hessu/arduino-powermunin/img/photo-sensor-installed1-800.jpg

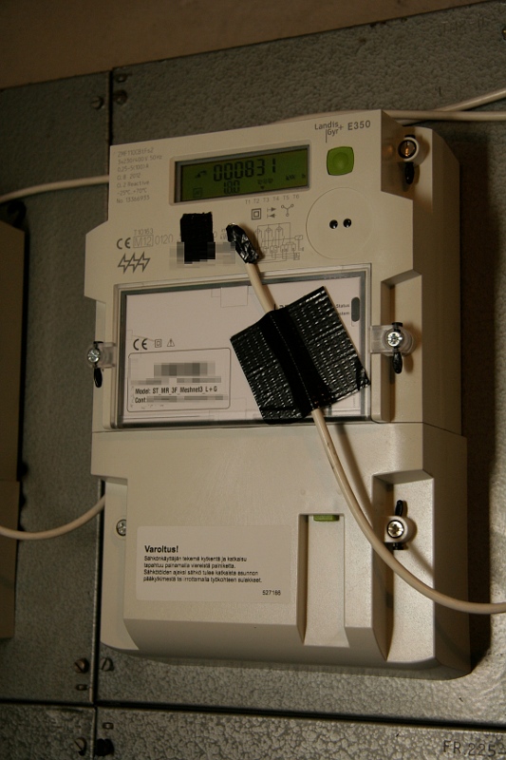
img/photo-sensor-installed1-800.jpg
