hessu/arduino-powermunin/README.md

arduino-powermunin
==================

This is a very simple but working project to monitor the blinking led on
common electricity meters (power meters) installed by utility companies.

Minimum amount of components and code, but it works. Takes one evening to
set up.

Example munin graph

License (same as Perl)
----------------------

This is free software; you can redistribute it and/or modify it under the
terms of either:

a) the GNU General Public License as published by the Free Software
Foundation; either version 1, or (at your option) any later version, or

b) the "Artistic License".

Required hardware
-----------------

1. An Arduino (I used a Duemilanove, but Uno, or anything else goes).
2. At least one phototransistor sensitive to visible light (many are only
   sensitive to infrared, and I don't know how much infrared a normal
   red LED produces). Osram SFH 300 seems to work fine. I used 5
   phototransistors since I'm monitoring 5 power meters!
3. 2 wires to connect the phototransistor to the Arduino (I used 5-wire
   phone cable, 3-wire telephone cable would work too, or just about
   anything else).
4. Header pins to stick in the Arduino's header for soldering the wires.
5. USB cable to connect the Arduino to a computer.

Theory of operation
-------------------

The Atmel microcontroller has an internal pull-up resistor which appears to
be adequate for driving the SFH 300.  The arduino code sets the digital I/O
pin to be an input, then writes HIGH to it, which enables internal pull-up. 
The I/O pin goes to HIGH state (+5V through the built-in pull-up resistor).

When the red led of the power meter blinks, the phototransistor starts to
conduct, short-circuiting the I/O pin to ground (through the pull-up
resistor which kindly limits the current to some nice value which don't care
much about).  The input pin's value is read by the arduino code, and it now
shows a LOW value.  When the light goes out, the phototransistor stops
conducting and the voltage on the I/O pin goes back up to 5V, and a
digitalRead() in the arduino code reports HIGH again.

The arduino code runs in a loop, reads I/O pin states, counts the amount of
blinks (how many times has a pin gone from HIGH to LOW), and prints the
counts on the (USB) serial port every 5 seconds.

A daemon written in Perl (powermunind) reads the reports on the serial port,
prints them to a state file on disk (or tmpfs to reduce disk I/O or flash
wearout).

A munin plugin written as a very simple shell script (power_munin) dumps the
contents of that state file when run by the munin agent.

Building and Installation instructions (short version)
------------------------------------------------------

1. Install a single phototransistor (i used Osram SFH 300) to an IO pin
   of the Arduino.  Used pins are defined in the arduino source code. 
   Connect the short lead (collector) to the IO pin and the long lead
   (emitter) to a ground pin of the Arduino.  When using multiple sensors,
   tie all emitters to the same ground pin.
2. Install the blinkcount Arduino code (found in the blinkcount
   subdirectory) on the Arduino.
3. Test the setup by pointing the phototransistor at a bright light source,
   or bringing it very close to a burning led light.  Observe accumulated
   counters printed on the USB serial port using the Arduino IDE's serial
   monitor.
4. Tape the phototransistor tightly in front of the red blinking led
   of the electricity meter.  It's a bit unsensitive, so make sure the led
   and the phototransistor are aligned to point directly at each other.  If
   the meter is in a well-luminated place instead of a dark closet like
   mine, put black tape on the back of the transistor so that the light from
   the outside does not interfere.
5. Run src/powermunind which collects counter increments and dumps them
   to a state file. Put it in a startup script such as /etc/rc.local
   so that it starts up after a reboot.
6. Install src/power_munin munin plugin which gives out the state file
   to munin. Optionally, set some configuration within the script.

Adjustments for different power meters
--------------------------------------

On my power meter the led blinks 1000 times per kWh, meaning 1 blink is 1 Wh
(1 watt consumed in 1 hour).  Munin, by default, prints the amount of blinks
per second - it divides the amount of blinks by the amount of seconds in the
5-minute plotting interval (roughly 300 seconds).

I wished to plot the average power consumption within the 5 minute polling
interval instead (in Watts), so I multiply Munin's blinks/s (watthours/s)
value by 3600, resulting in a displayed value of watthours/hour, i.e. 
watts.

The multiplication is done by RPN math in rrdtool, configured in the
power_munin script's configuration section for each port:

    port0.cdef port0,3600,*

This takes port0's current value, and multiplies it by 3600.  If your power
meter would only blink 500 times per kWh, you'd have to multiply it by 7200
to display watts. The RRD files stored on disk will in any case store the
blinks per second value for each interval.

FAQ
---

**Is this legal?**

Yes, we're not actually connecting any wires to the meter. There is only an
optical coupling between the meter and the sensor - no electricity flowing
between the meter and our stuff.

**Is this safe?**

Yes, see the previous question.  It's about as safe as taking photographs of
the meter (which is, indeed, quite safe).

**Privacy considerations?**

Yes! Don't publish the measurements of your home meter on the Internet just
like that - everyone can see when you're at home and when you're away. 
Don't measure the power consumption of other people without their explicit
consent.
