hessu/arduino-powermunin/img/munin-power_a3-day.png

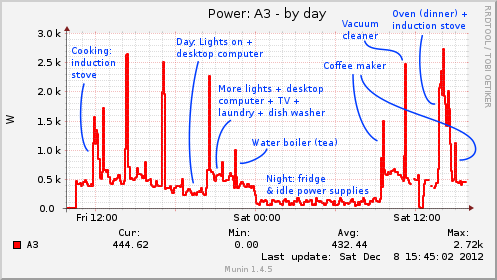
img/munin-power_a3-day.png
