hessu/arduino-powermunin/img/photo-arduino-wires-800.jpg

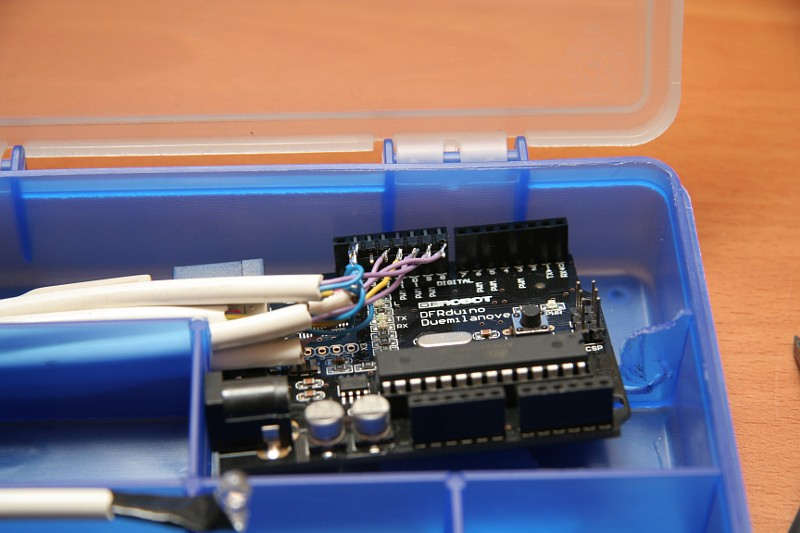
img/photo-arduino-wires-800.jpg
