hessu/arduino-powermunin/img/photo-box-wall-800.jpg

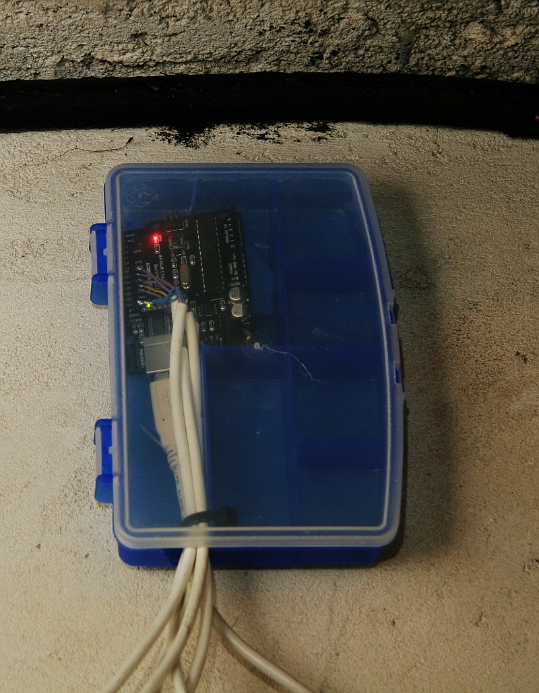
img/photo-box-wall-800.jpg
