hessu/arduino-powermunin/img/photo-phototransistor-800.jpg

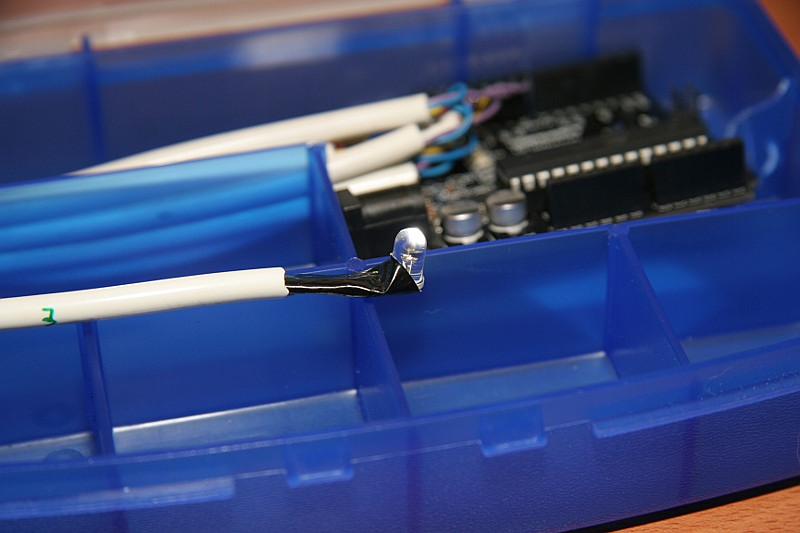
img/photo-phototransistor-800.jpg
