hessu/arduino-powermunin/img/photo-sensor-installed2-800.jpg

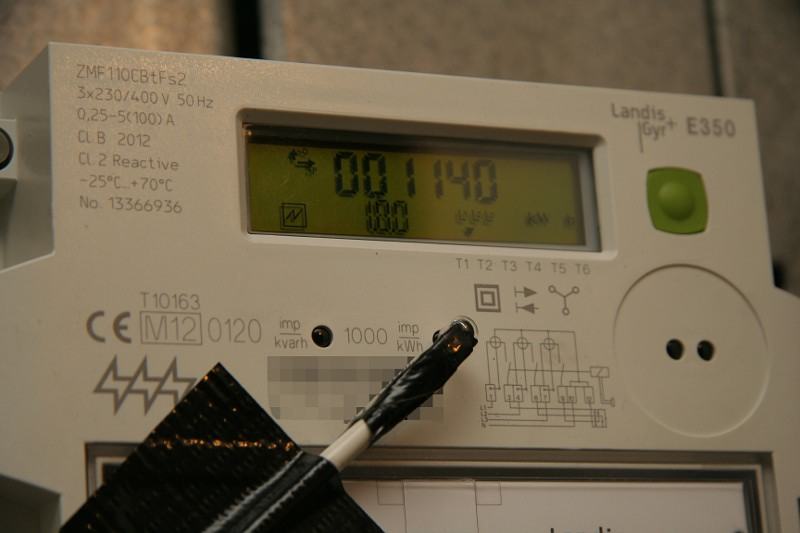
img/photo-sensor-installed2-800.jpg
